magnusbauer/flowersofthings/images/schematic.sch

## EAGLE design images/schematic.sch (2018-08-30)

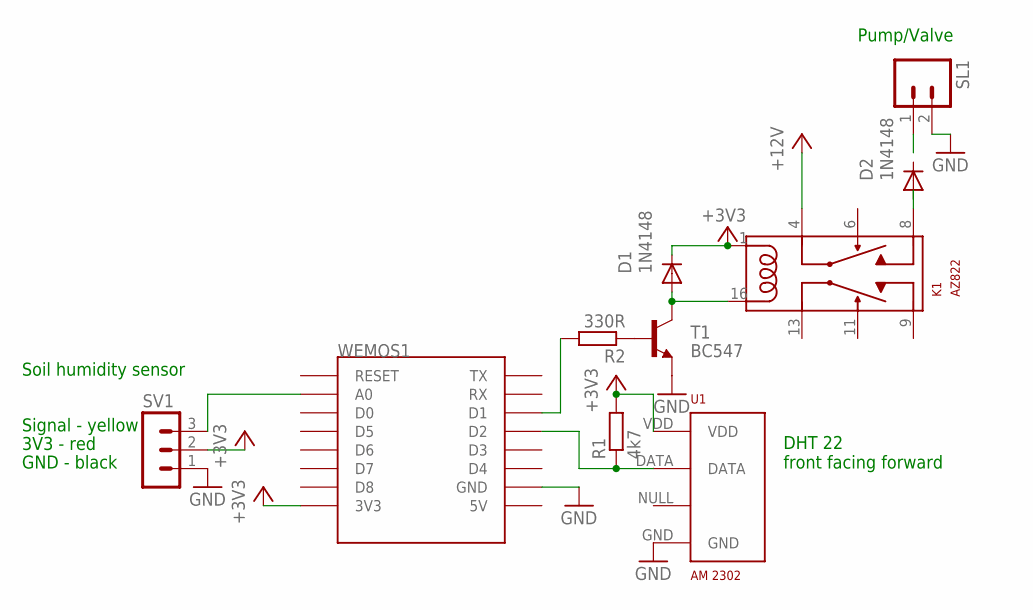
[picture p4: schematic schematic.sch]

Parts:
D1, D2: 1N4148; DO35-10
K1: AZ822; 351
R1: 4k7; 0207/10
R2: 330R; 0207/10
SL1: M02; 02P
SV1: MA03-1
T1: BC547; TO92
U1: AM 2302; RHT03_DHT-22
WEMOS1: WEMOS-D1-MINI

Connections:
+3V3: D1.C, K1.1, K1.4, R1.2, SV1.2, U1.VDD, WEMOS1.3V3
GND: SL1.2, SV1.1, T1.1 (E), U1.GND, WEMOS1.GND
unnamed: R1.1, U1.DATA, WEMOS1.D2
unnamed: D1.A, K1.16, T1.3 (C)
unnamed: SV1.3, WEMOS1.A0
unnamed: R2.2, WEMOS1.D1
unnamed: R2.1, T1.2 (B)

Notes on the sheet:
GND - black
3V3 - red
Signal - yellow
Soil humidity sensor
DHT 22 front facing forward
Pump/Valve
