magnusbauer/flowersofthings/(commit log)

2018-08-30 changes in sketch and data. variables saved in config.json for restart. cleaned sketch
    [temp1.csv]
2018-08-30 added eagle schematic
    [schematic.sch]
